Rohde-Schwarz-Garage/hw-it-halloween-led-house/Bilder/3.jpg

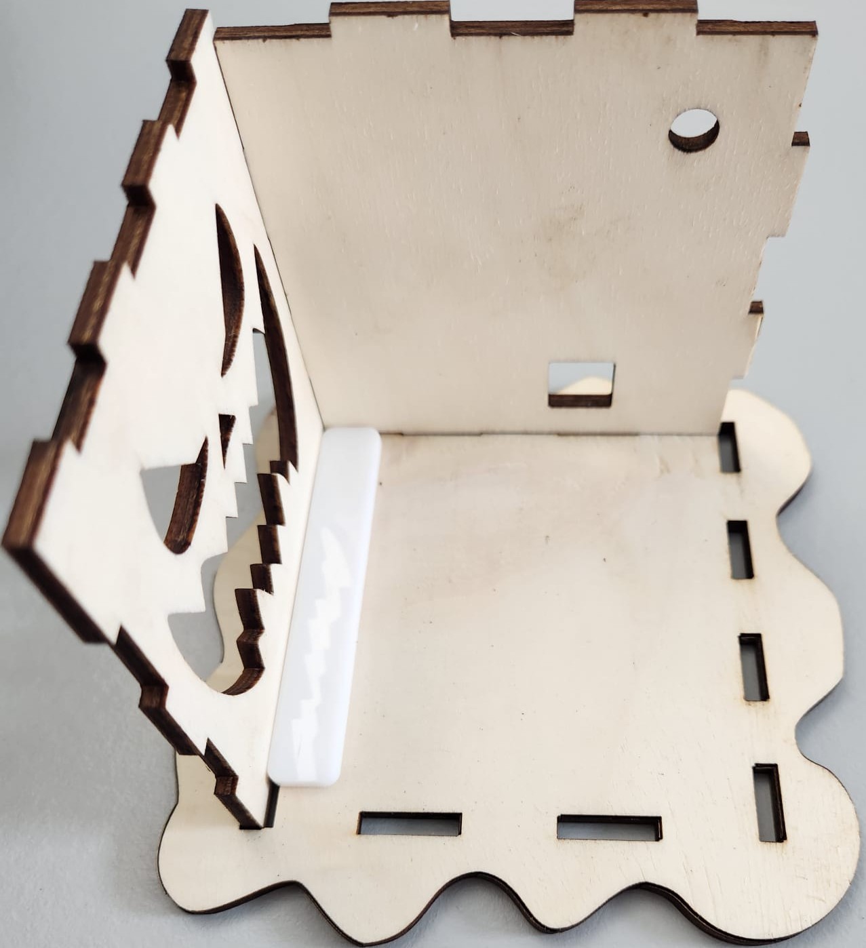
Bilder/3.jpg
