Rohde-Schwarz-Garage/hw-it-halloween-led-house/Bilder/4.jpg

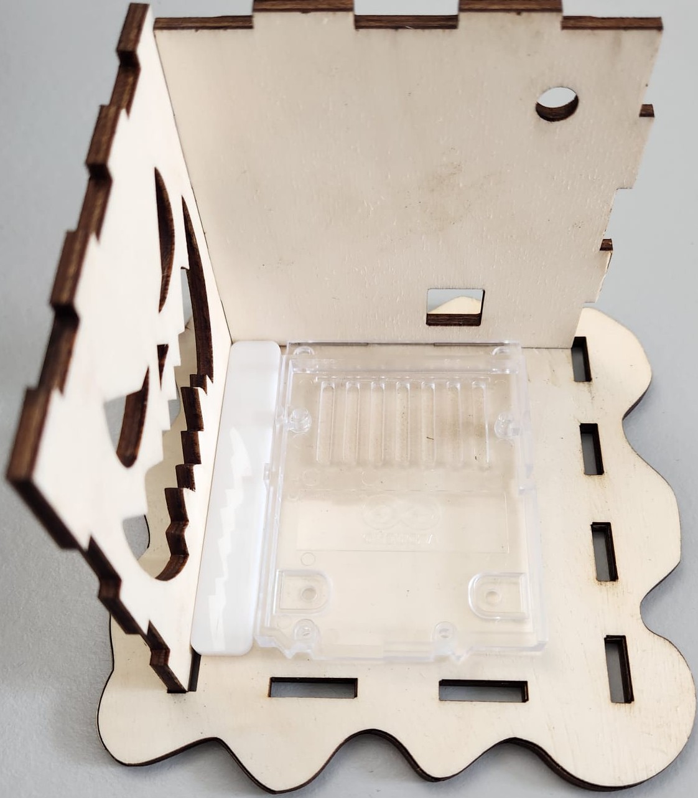
Bilder/4.jpg
