Rohde-Schwarz-Garage/hw-it-halloween-led-house/Bilder/5.jpg

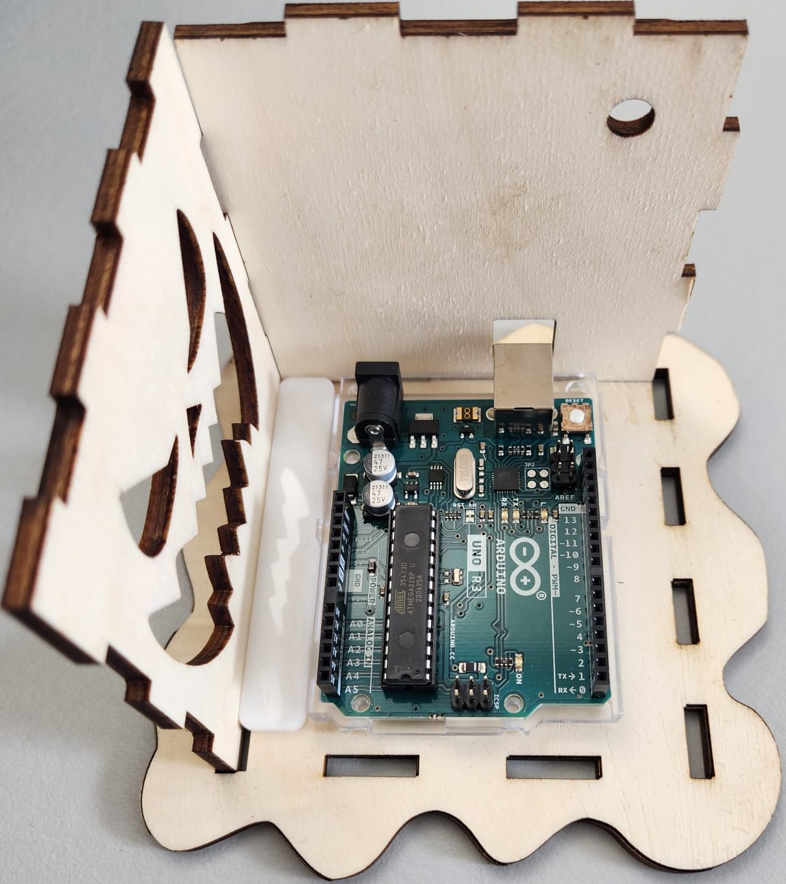
Bilder/5.jpg
