Rohde-Schwarz-Garage/hw-it-halloween-led-house/Bilder/AI_Werbebild.png

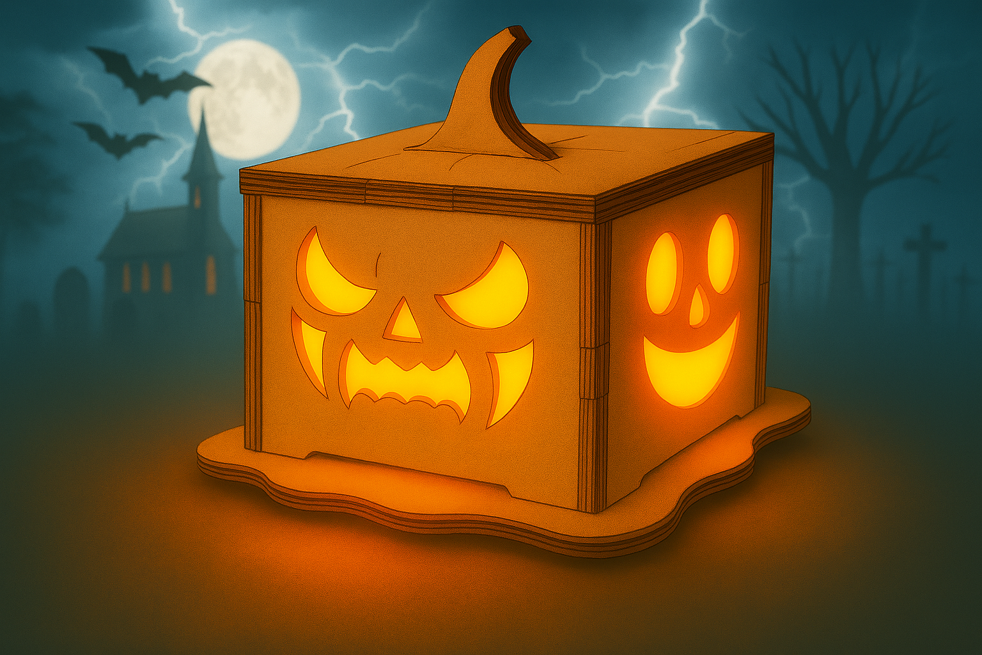
Bilder/AI_Werbebild.png
