Rohde-Schwarz-Garage/hw-it-halloween-led-house/Bilder/LB2.png

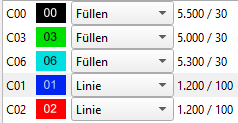
Bilder/LB2.png
